giocaizzi/picow-ws2812/README.md

# picow-ws2812

A package to power a ws2812b LED wall matrix.
