giocaizzi/picow-ws2812/(commit log)

2026-03-04 feat: implement Pi5→Pico W streaming architecture
    Migrate tooling from Poetry to uv workspace with ruff. Add custom UDP
    protocol for frame streaming, Pico W receiver with frame buffer, WiFi
    manager with auto-reconnect, fallback display mode, and multi-strip
    indexer. Add Pi5 ledwall-server package with FastAPI, plugin system
    (clock, text, effects, image), renderer/compositor, and scene manager.
2026-03-04 feat(plugins): implement composable plugin & dashboard system
    Add three-level composition architecture for the LED wall:
    - Elements (TextElement, IconElement, RectElement, BarElement) as
    reusable visual building blocks
    - Screens with ScreenManager supporting fixed, auto-cycle, and scroll
    transition modes
    - Per-layer sizing in scene config for dashboard layouts
    Rewrite Weather plugin to fetch live data from Open-Meteo API with
    icon+text screens. Rewrite Clock to use elements/screens internally.
    Register StaticImage and AnimatedGif plugins. Add dashboard scene
    with weather, clock, and scrolling text. Rewrite devtools visualizer
    for plugin/scene preview.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
2026-03-04 vscode global settings and extensions for Pico W development
2026-03-04 wiring schema
2026-03-04 init 3d
    [ledwall_enclosure.scad]
2026-03-04 feat(3d): switch to blind nail mount, remove keyholes
    [ledwall_enclosure.scad]
2026-03-04 feat(3d): add shelf for LED panels with wiring channels (Schema 2)
    [ledwall_enclosure.scad]
2026-03-04 feat(3d): enhance comments for clarity in ledwall_enclosure.scad
    [ledwall_enclosure.scad]
2026-03-04 fix(3d): update LED panel arrangement to landscape orientation
    [ledwall_enclosure.scad]
2026-03-14 feat(devtools): add PNG/GIF export and CLI preview for LED wall
    - Fix pytest: remove broken --import-mode=importlib, add testpaths
    - Add save_snapshot() and save_animation() to LedWallVisualizer
    - Add `preview` CLI: `uv run preview Rainbow --gif --frames 60`
    - Fix notebooks: use %matplotlib ipympl for animation support
2026-03-14 fix(plugins): crisp 1-bit text rendering and extract shared font module
    Text was rendering with anti-aliasing (gray pixels) which looks muddy
    on LED displays. Now uses 1-bit PIL rendering for crisp on/off pixels.
    Extracts duplicated font loading into shared fonts.py module.
2026-03-14 fix(visualizer): render initial frame in animations, clear stale outputs
    FuncAnimation without init_func left the first frame black — the saved
    notebook widget fallback image showed nothing. Added init_func to
    preview_plugin and preview_scene so the first frame renders immediately.
    Cleared all stale notebook outputs.
2026-03-14 refactor(devtools): remove notebooks, use CLI-only preview workflow
    Notebooks were a poor fit for LED previews — animations only worked
    live, saved outputs were always black, and each cell overwrote the
    previous animation. The CLI produces reproducible PNG/GIF files.
    - Remove all 3 notebooks (static, animations, scenes)
    - Remove ipykernel/ipympl dev dependencies
    - Default output to backend/previews/ (gitignored)
    - Remove dead interactive methods from visualizer
    - Update CLAUDE rules with CLI usage
2026-03-14 fix(diagram): update wiring diagram to reflect GP28 pin usage and improve data chain clarity
2026-03-14 feat(devtools): add panel outline, scenes, data plugins, and subfolder output
    - Add subtle gray border around LED panel for spatial reference
    - CLI supports plugins, data plugins (Bitcoin, Weather), and scenes
    - Output organized into previews/plugins/ and previews/scenes/
    - `uv run preview` exports all plugins + scenes with GIFs
    - `uv run preview Rainbow` exports a single target
2026-03-14 fix(docs): rewrite wiring diagram with clear data routing and consistent styling
    - Rewrite both Schema 1 and Schema 2 SVGs from scratch
    - Fix data chain from Pico GP28: direct L-path crossing bus, no detour
    - Route DOUT→DIN chains through gaps between panels (no overlap)
    - Fix GPIO pin: GP0 → GP28 to match actual code in main.py
    - Move panel text to x=810 to avoid MID connector overlap in Schema 2
    - Standardize all line widths: bus 3px, connections 2px
    - Remove arrow markers, use dashed lines for data chain
    - Add numbered step labels (①-⑤) on data chain
    - Place Pico pin labels above their lines for readability
